stefanschramm/z80experiments/08_uartloader/jump.py

#!/usr/bin/python

import struct

#tty = open("/dev/ttyS0", "w")
tty = open("/dev/ttyUSB0", "w")

# call 'jump' command
tty.write("J")
# write memory address to exec (begin of memory)
tty.write(struct.pack("<H", 0x8000))

tty.close
