stefanschramm/z80experiments/(commit log)

2011-08-08 some sources
    [05_schematics.sch]
2011-09-03 schematics 01
    [01_schematics.sch]
2011-09-03 uart blink and output experiments
    [06_uartblink.sch]
2011-09-03 input from uart tests
2011-09-17 moved blinkenlichten to extra
    [05_schematics.sch]
2011-09-17 renamed experiments
    [06_uartblink.sch]
2011-09-17 renamed experiments; moved blinkenlichten to extra
    [schematics.sch]
2011-09-17 removed old stuff; fixed symlink
    [05_schematics.sch]
2011-09-17 moved/renamed schematics
    [schematics.sch]
2011-09-17 renamed asm files and schematics
    [schematics.sch]
